hotchk155/orange-squeeze/docs/packing slip.pdf

Thank you for purchasing ORANGE SQUEEZE! I hope you find it useful and enjoy using it. For information please see http://six4pix.com/squeeze
You can contact me with questions or feedback at sixtyfourpixels@gmail.com

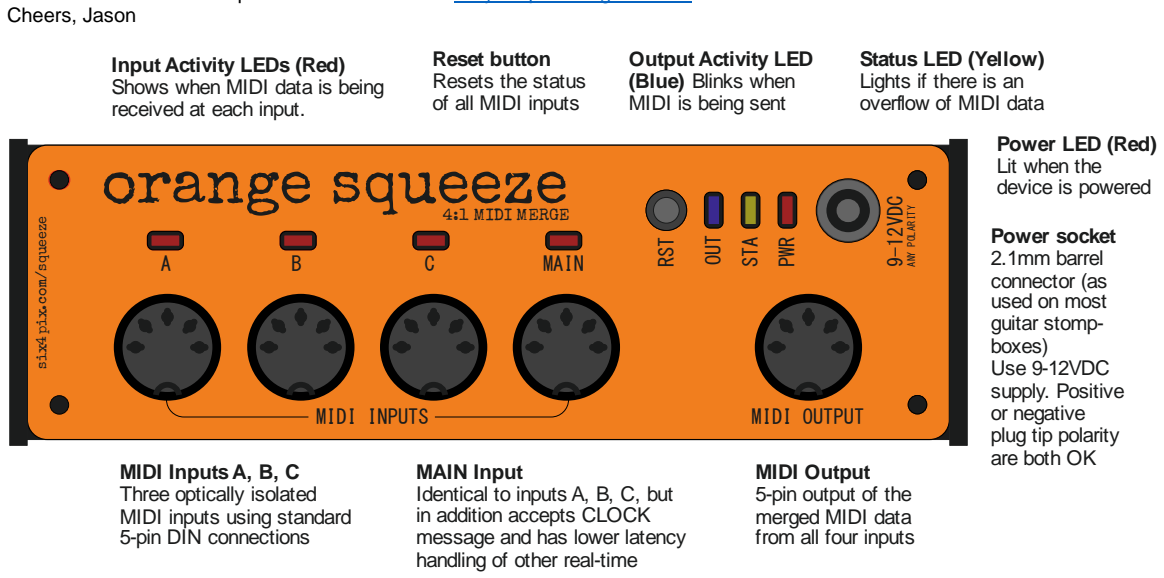
[picture p1: figure]
Cheers, Jason; MIDI Inputs A, B, C Three optically isolated MIDI inputs using standard 5-pin DIN connections; Power LED (Red) Lit when the device is powered; Output Activity LED (Blue) Blinks when MIDI is being sent; Reset button Resets the status of all MIDI inputs; Power socket 2.1mm barrel connector (as used on most guitar stomp- boxes) Use 9-12VDC supply. Positive or negative plug tip polarity are both OK MAIN Input; Identical to inputs A, B, C, but in addition accepts CLOCK message and has lower latency handling of other real-time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

messages

Thank you for purchasing ORANGE SQUEEZE! I hope you find it useful and enjoy using it. For information please see http://six4pix.com/squeeze
You can contact me with questions or feedback at sixtyfourpixels@gmail.com

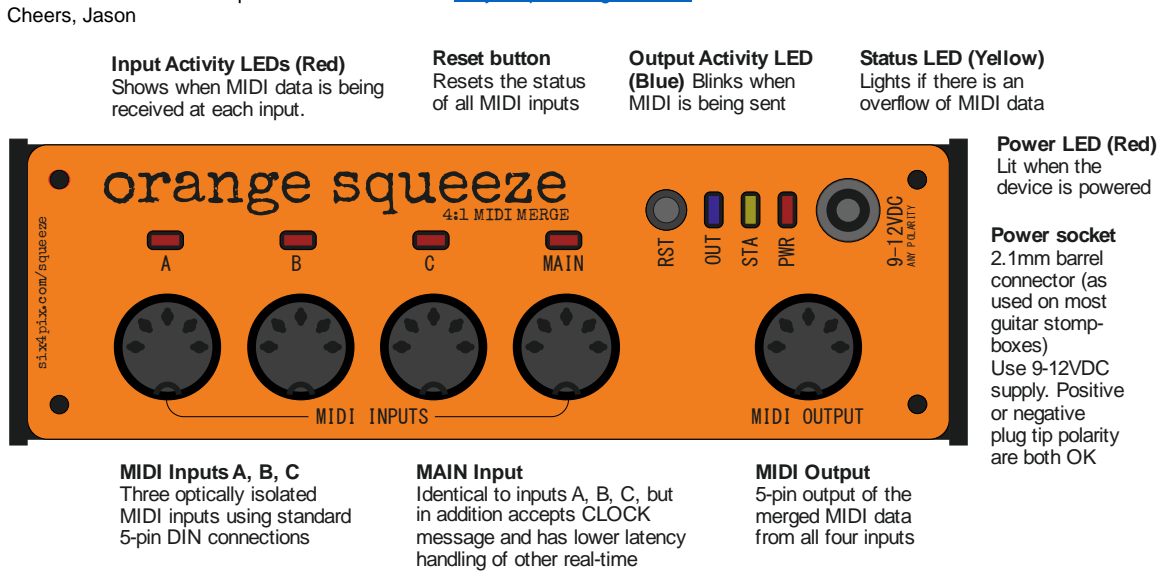
[picture p2: figure]
Cheers, Jason; MIDI Inputs A, B, C Three optically isolated MIDI inputs using standard 5-pin DIN connections; Power LED (Red) Lit when the device is powered; Output Activity LED (Blue) Blinks when MIDI is being sent; Reset button Resets the status of all MIDI inputs; Power socket 2.1mm barrel connector (as used on most guitar stomp- boxes) Use 9-12VDC supply. Positive or negative plug tip polarity are both OK MAIN Input; Identical to inputs A, B, C, but in addition accepts CLOCK message and has lower latency handling of other real-time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

messages
