hotchk155/orange-squeeze/jig/brd.png

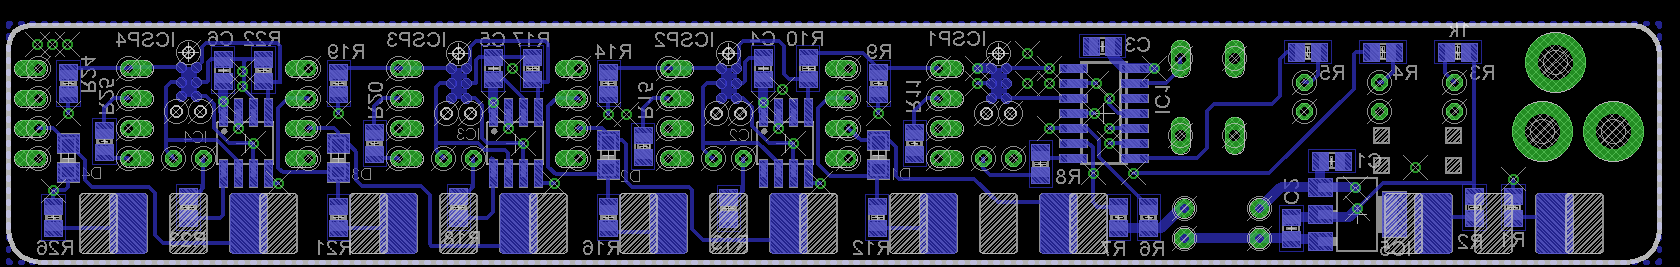
jig/brd.png
