hotchk155/orange-squeeze/hardware/mini-midi-merge.brd

## EAGLE design hardware/mini-midi-merge.brd (2016-07-09)

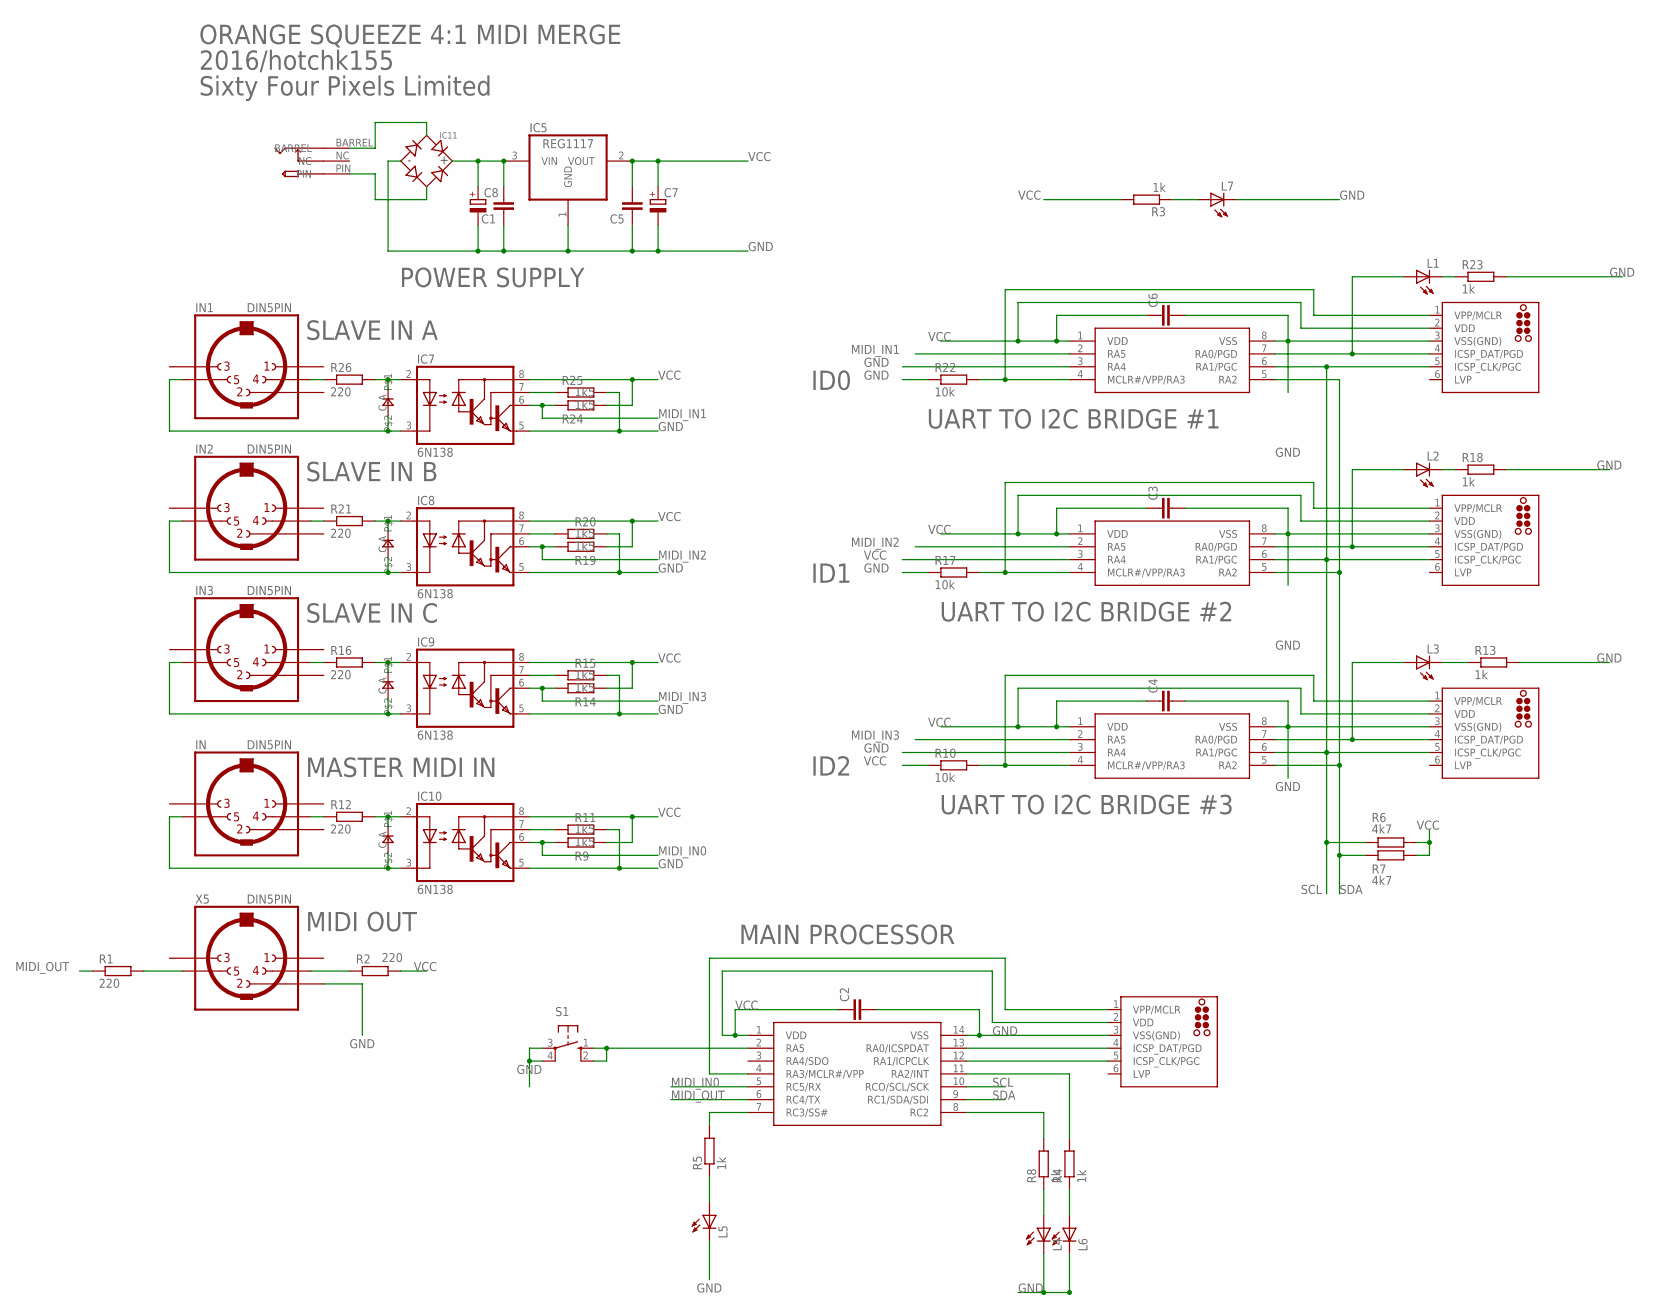
[picture p4: schematic mini-midi-merge.sch]

Parts:
C1, C2, C3, C4, C5, C6: C-EUC0805; C0805
C7, C8: CPOL-EUE2,5-6E; E2,5-6E
D1, D2, D3, D4: 0805DIODE
IC1: PIC16F1825SO14; SO14
IC2, IC3, IC4: PIC12F1822SO08; SO08
IC5: REG1117; SOT223
IC7, IC8, IC9, IC10: 6N138; DIL08
IC11: BRIDGERECTIFIER; SOIC-4
ICSP1, ICSP2, ICSP3, ICSP4: TC2030-MCP-NL
IN, IN1, IN2, IN3: DIN5PIN; EDGEDIN
L1, L2, L3, L4, L5, L6, L7: LED3MM
R1, R2, R12, R16, R21, R26: 220; R0805
R3, R4, R5, R8, R13, R18, R23: 1k; R0805
R6, R7: 4k7; R0805
R9, R11, R14, R15, R19, R20, R24, R25: 1k5; R0805
R10, R17, R22: 10k; R0805
S1: 10-XX; B3F-10XX
U$9: PWR_SOCKET_2_1MM
X5: DIN5PIN; EDGEDIN

Connections:
GND: C1.1, C2.2, C3.2, C4.2, C5.1, C6.2, C7.-, C8.-, IC1.14 (VSS), IC2.3 (RA4), IC2.8 (VSS), IC3.8 (VSS), IC4.3 (RA4), IC4.8 (VSS), IC5.1 (GND), IC7.5 (GND), IC8.5 (GND), IC9.5 (GND), IC10.5 (GND), IC11.-, ICSP1.3 (VSS(GND)), ICSP2.3 (VSS(GND)), ICSP3.3 (VSS(GND)), ICSP4.3 (VSS(GND)), L4.K (C), L5.K (C), L6.K (C), L7.K (C), R11.2, R13.2, R15.2, R17.1, R18.2, R20.2, R22.1, R23.2, R25.2, S1.3, S1.4 (P1), X5.2
MIDI_IN0: IC1.5 (RC5/RX), IC10.6 (VO), R9.1
MIDI_IN1: IC4.2 (RA5), IC7.6 (VO), R24.1
MIDI_IN2: IC3.2 (RA5), IC8.6 (VO), R19.1
MIDI_IN3: IC2.2 (RA5), IC9.6 (VO), R14.1
MIDI_OUT: IC1.6 (RC4/TX), R1.1
unnamed: IN3.4, R16.1
unnamed: D2.A, IC9.2 (A), R16.2
unnamed: D2.C, IC9.3 (C), IN3.5
unnamed: IN2.4, R21.1
unnamed: IC9.7 (VB), R15.1
unnamed: D3.A, IC8.2 (A), R21.2
unnamed: D3.C, IC8.3 (C), IN2.5
unnamed: IC8.7 (VB), R20.1
unnamed: IN1.4, R26.1
unnamed: D4.A, IC7.2 (A), R26.2
unnamed: D4.C, IC7.3 (C), IN1.5
unnamed: IC7.7 (VB), R25.1
unnamed: IN.4, R12.1
unnamed: D1.A, IC10.2 (A), R12.2
unnamed: D1.C, IC10.3 (C), IN.5
unnamed: IC10.7 (VB), R11.1
unnamed: IC3.4 (MCLR#/VPP/RA3), ICSP3.1 (VPP/MCLR), R17.2
unnamed: IC4.4 (MCLR#/VPP/RA3), ICSP4.1 (VPP/MCLR), R22.2
unnamed: L4.A, R8.1
unnamed: C1.2, C8.+, IC5.3 (VIN), IC11.+
unnamed: L7.A, R3.1
unnamed: R1.2, X5.5
unnamed: IC4.7 (RA0/PGD), ICSP4.4 (ICSP_DAT/PGD), L1.A
unnamed: L1.K (C), R23.1
unnamed: IC2.7 (RA0/PGD), ICSP2.4 (ICSP_DAT/PGD), L3.A
unnamed: L2.K (C), R18.1
unnamed: IC2.4 (MCLR#/VPP/RA3), ICSP2.1 (VPP/MCLR), R10.2
unnamed: R2.1, X5.4
unnamed: IC3.7 (RA0/PGD), ICSP3.4 (ICSP_DAT/PGD), L2.A
unnamed: L3.K (C), R13.1
unnamed: IC1.4 (RA3/MCLR#/VPP), ICSP1.1 (VPP/MCLR)
unnamed: L6.A, R4.1
unnamed: IC1.13 (RA0/ICSPDAT), ICSP1.4 (ICSP_DAT/PGD)
unnamed: IC1.12 (RA1/ICPCLK), ICSP1.5 (ICSP_CLK/PGC)
unnamed: IC1.8 (RC2), R8.2
unnamed: IC1.11 (RA2/INT), R4.2
unnamed: IC11.~1 (AC1), U$9.BARREL
unnamed: IC11.~2 (AC2), U$9.PIN
unnamed: IC1.2 (RA5), S1.1 (S), S1.2 (S1)
unnamed: IC1.7 (RC3/SS#), R5.2
unnamed: L5.A, R5.1
SCL: IC1.10 (RCO/SCL/SCK), IC2.6 (RA1/PGC), IC3.6 (RA1/PGC), IC4.6 (RA1/PGC), ICSP2.5 (ICSP_CLK/PGC), ICSP3.5 (ICSP_CLK/PGC), ICSP4.5 (ICSP_CLK/PGC), R6.1
SDA: IC1.9 (RC1/SDA/SDI), IC2.5 (RA2), IC3.5 (RA2), IC4.5 (RA2), R7.1
VCC: C2.1, C3.1, C4.1, C5.2, C6.1, C7.+, IC1.1 (VDD), IC2.1 (VDD), IC3.1 (VDD), IC3.3 (RA4), IC4.1 (VDD), IC5.2 (VOUT), IC7.8 (VCC), IC8.8 (VCC), IC9.8 (VCC), IC10.8 (VCC), ICSP1.2 (VDD), ICSP2.2 (VDD), ICSP3.2 (VDD), ICSP4.2 (VDD), R2.2, R3.2, R6.2, R7.2, R9.2, R10.1, R14.2, R19.2, R24.2

Notes on the sheet:
POWER SUPPLY
UART TO I2C BRIDGE #1
UART TO I2C BRIDGE #2
UART TO I2C BRIDGE #3
MAIN PROCESSOR
SLAVE IN A
SLAVE IN B
SLAVE IN C
MASTER MIDI IN
MIDI OUT
ORANGE SQUEEZE 4:1 MIDI MERGE
2016/hotchk155
Sixty Four Pixels Limited
ID0
ID1
ID2

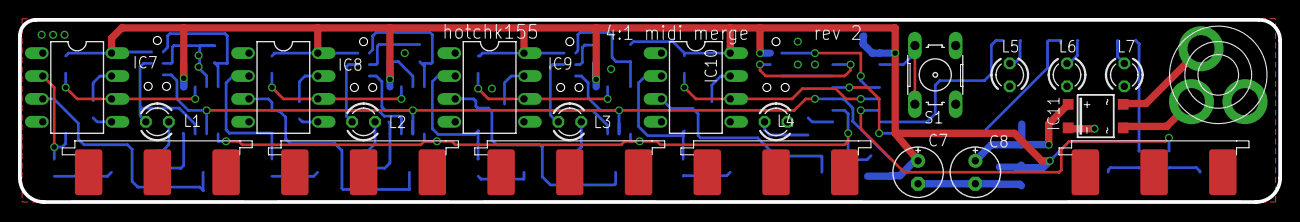
[picture p5: board mini-midi-merge.brd from above]

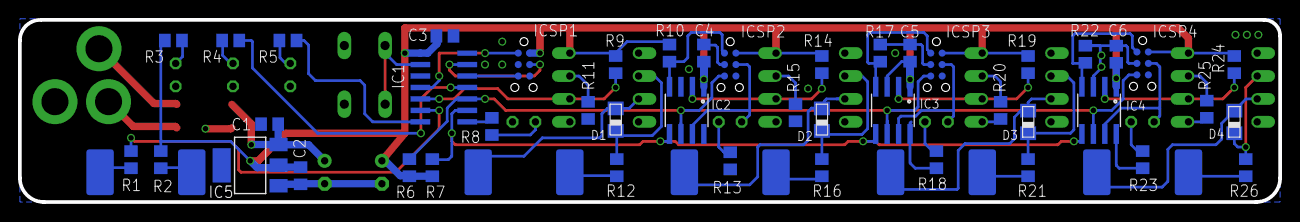
[picture p6: board mini-midi-merge.brd from below]

Board: 2 copper layers, 139.7 x 20.2 mm, 66 parts (45 on the bottom side), 50 nets.
