hotchk155/orange-squeeze/master/mmmerge.h

////////////////////////////////////////////////////////////
//
//           ///    //// /////  /////   /////   ////
//         //  // //        // //  // //   // //  //
//        //  // //     ///// //  //  ////// //////
//       //  // //    //  // //  //      // //
//        ////  //     ///// //  //   /////  /////   
//
//      ////  ///// //  //  ////   //// //////   //// 
//    //    //  // //  // //  // //  //    //  //  //
//    ////  ///// //  // ////// //////   //   //////
//      //    // //  // //     //      //    //
//  ////     /// /////  /////  ////  //////  /////
//
////////////////////////////////////////////////////////////

#define I2C_ADDR 			0x70	// slave address #0

#define CMD_START			0x01	// Command byte to start MIDI receive
#define CMD_STOP			0x02	// Command byte to stop MIDI receive

#define SZ_SLAVEDATA 		50		
