hotchk155/orange-squeeze/(commit log)

2016-02-10 almost done
    [mini-midi-merge.brd, mini-midi-merge.sch]
2016-02-10 ground output pin 2
    [mini-midi-merge.brd, mini-midi-merge.sch]
2016-03-20 adding comp values
    [mini-midi-merge.brd, mini-midi-merge.sch]
2016-07-09 tidy up schematic
    [mini-midi-merge.sch]
2016-07-09 PCB REV2
    move switch to match bsplit
    [mini-midi-merge.brd]
2016-11-29 adding test code
    [sysex.xlsx]
